gunnarfandrich/Sentinel/docs/Orin_Flashing.md

# Flashing the Jetson Orin Nano & Other/Older Variants

## Introduction
The Jetson Nano can prove difficult to flash due to the lack of documentation available online. This
document serves to fill in the gaps and aid in flashing all three developer kit models that exist at the
time of writing.

### Required Computer/Software
* A device with at least 64GB of storage running Ubuntu is required to
flash a Jetson Nano and its variants. Other linux distributions may work, though are untested.

  * Jetson Orin Nano: Ubuntu 20.04 or 22.04
  * (Older) Jetson Nano: Ubuntu 18.04

* An Nvidia account https://developer.nvidia.com/login

> **NOTE**  
> It would be advised to simply install Ubuntu to a removable storage device (such as an SD card
or USB drive) to avoid issues with installing to your main computer. A Live-CD cannot be used for
flashing a Jetson due to its lack in storage capacity.

### Required Hardware

A variant of the Jetson Orin Nano, or a variant of the older Jetson Nano (An incomplete list of variants are listed below)

<table border=1 frame=void rules=rows>
<tr>
<th>Variant</th>
<th>Device View</th>
</tr>
<tr>
<td>

Jetson Orin Nano Developer Kit
* Dev-22098
  * 8GB Model, without EMMC. Requires an NVME storage device to be installed.
  
> **NOTE**  
> Alternatively use a USB or SD Card, though these devices will be extremely slow and will face accelerated flash degredation in comparison to an NVME and are not recommended.

</td>
<td>
 


</td>
</tr>

<tr>
<td>

Jetson Nano Developer Kit 
* P3448-0003
  * 2GB model, without EMMC. Requires an SD card for the OS
to be installed to.
* P3448-0000
  * 4GB model, without EMMC. Requires an SD card for the OS
to be installed to.
* P3448-0002
  * 4GB model, with 16GB EMMC. Does NOT require an SD
card.

</td>
<td>

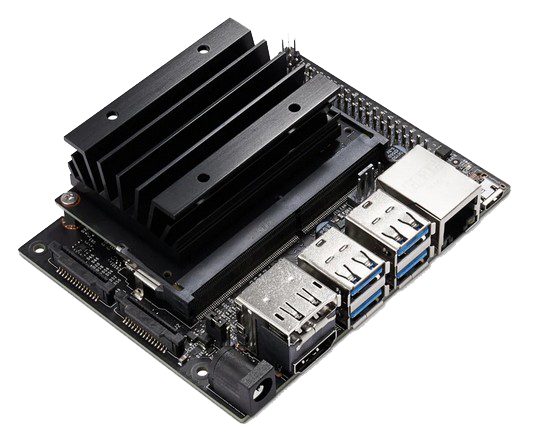
[picture p9: images/flashing/nano.png]


</td>
</tr>

<tr>
<td>

Jetson Xavier NX Developer Kit
* (Model number is unknown, but the internal PN is: 812674024318)
  * 16GB model, with 16GB EMMC.

</td>
<td>

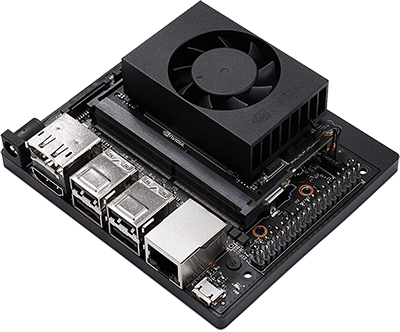
[picture p10: images/flashing/xavier.png]


</td>
</tr>

<tr>
<td>

Jetson AGX Orin Developer Kit
* (Model number is unknown, but the internal PN is: 945-13730-0000-000)
  * 64GB model, with 64GB EMMC.

</td>
<td>

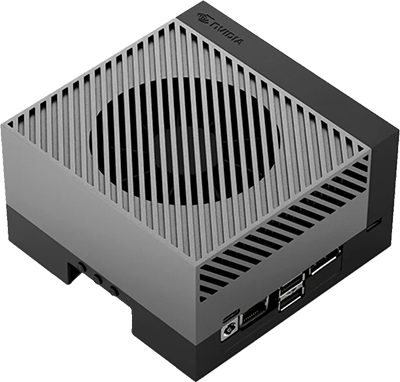
[picture p11: images/flashing/orin_agx.png]


</td>
</tr>
</table>

<table border=1 frame=void rules=rows>
<tr>
<th>Component</th>
<th>Component View</th>
</tr>
<tr>
<td>

* Standard Computer Jumper
  * These can be borrowed from an old computer motherboard you
may have laying around.
> **NOTE**  
>  A Female to Female breadboard wire will work in a
pinch.

</td>
<td>

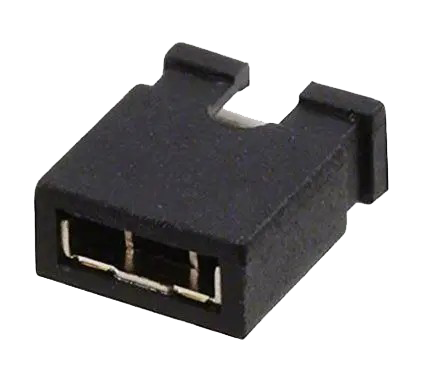
[picture p12: images/flashing/jumper.png]


</td>
</tr>
<tr>
<td>

(Micro-USB or USB-C) cable
  * Depending on the model daughter-board to be flashed, a Micro-
USB or USB-C cable is needed to connect the board to another
computer.

</td>
<td>

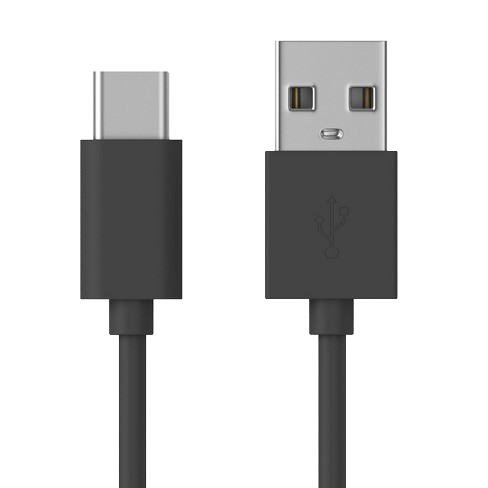
[picture p13: images/flashing/cable.png]


</td>
</tr>

<tr>
<td>
 
Power Supply (12V barrel jack or Micro-USB or USB-C)
  * Depending on the model daughterboard to be flashed, a 12V barrel
jack supply, Micro-USB, or USB-C power supply is necessary to
ensure a stable power supply while flashing.

</td>
<td>

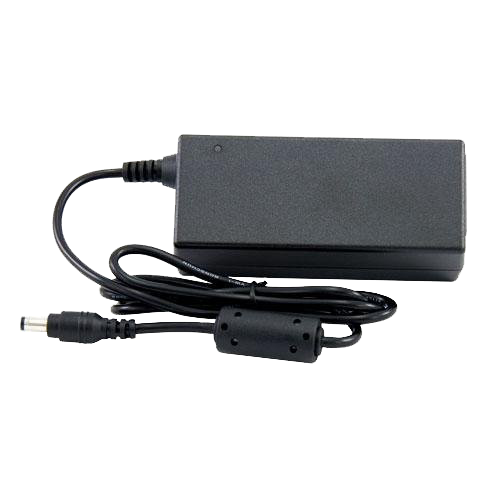
[picture p14: images/flashing/psu.png]


</td>
</tr>
</table>

## Flashing and Software Installation Process

### SDK Manager Installation

Navigate to the [Nvidia Website](https://developer.nvidia.com/sdk-manager) and download the appropriate package file for your desired operating system. For ubuntu, select the .deb file.

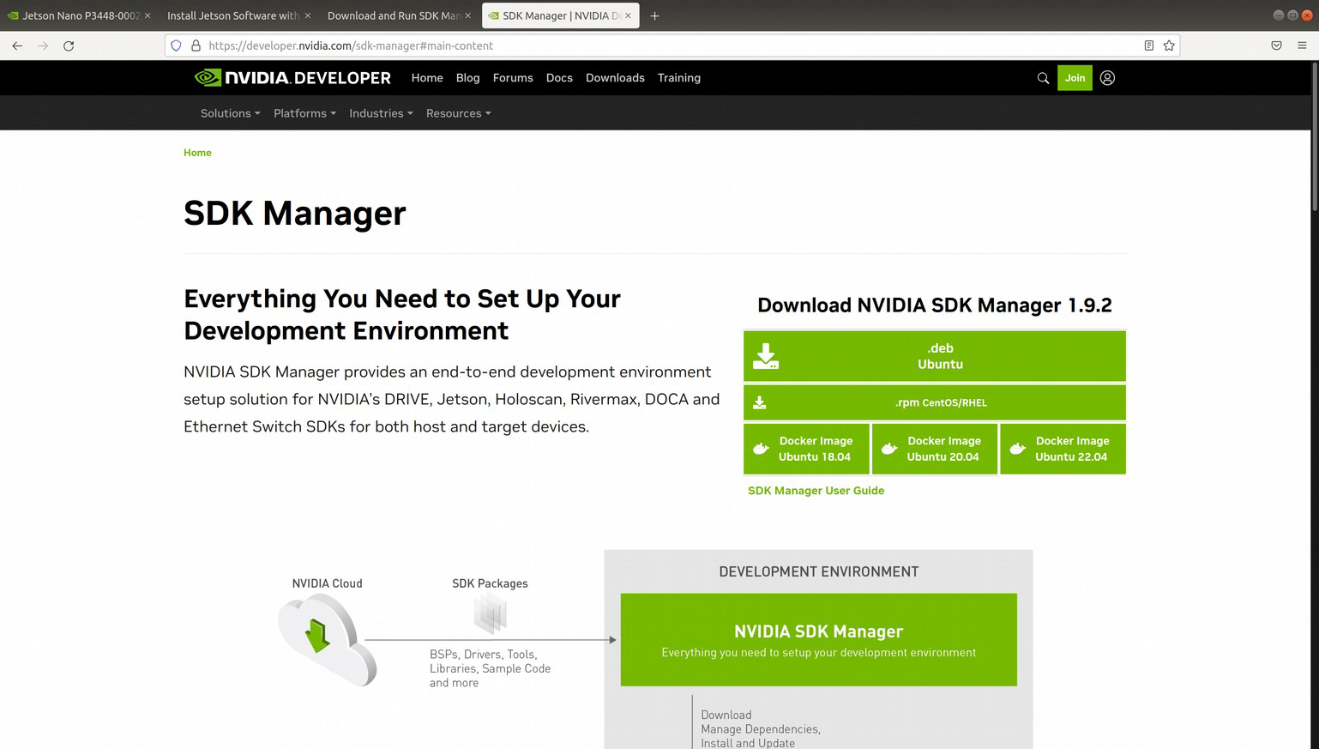
[picture p15: images/flashing/login.png]


Open a terminal and cd to the location of the downloaded file:
```sh
cd ~/Downloads
```

Attempt to install the sdkmanager:
```sh
sudo dpkg -i sdkmanager*.deb
```

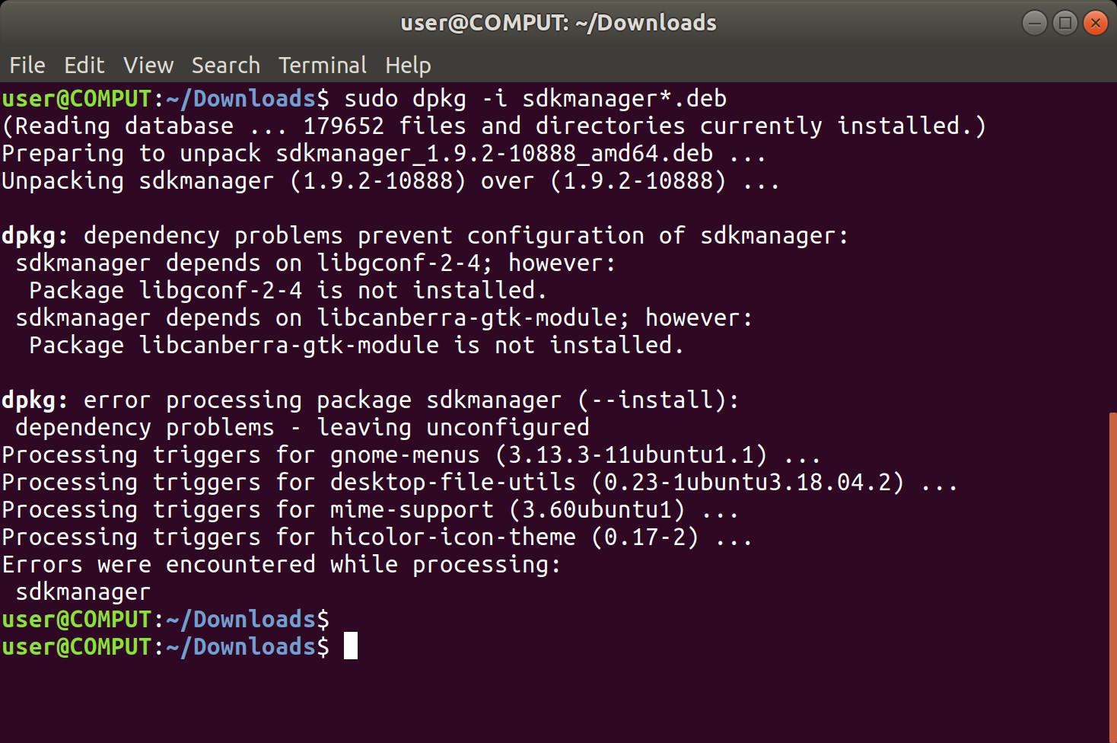
[picture p16: images/flashing/sdkmanager.png]


It is likely some dependencies will be missing. Common dependencies can be installed with the
following command:

```sh
sudo apt-get install libgconf-2-4 libcanberra-gtk-module gconf-service gconf2-common
libcanberra-gtk0 gconf-service-backend
```

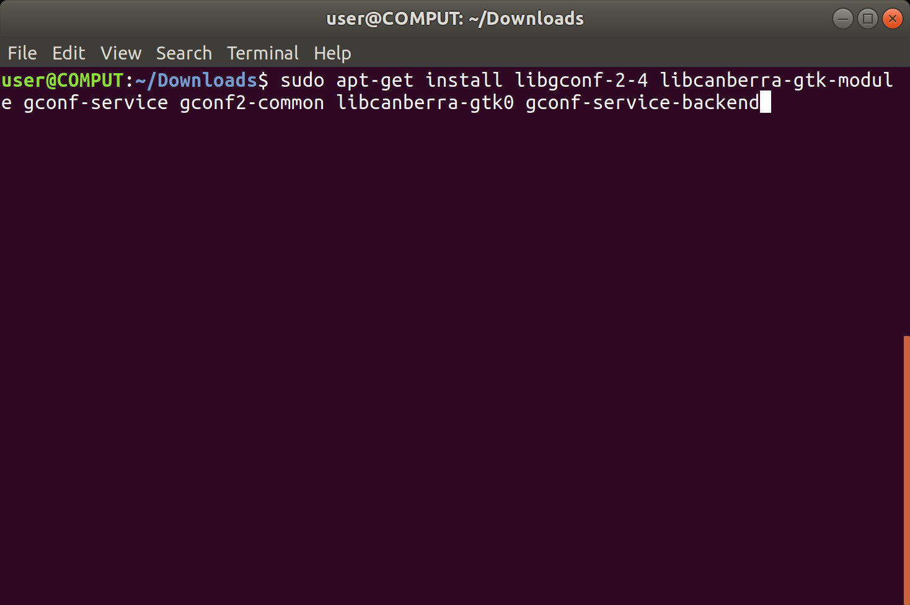
[picture p17: images/flashing/dependencies.png]


> **NOTE**
>  If any additional dependencies are required, simply review the terminal log to find the missing
packages and install them. An example is given below:
> ```sh
> sudo apt-get install libgconf-2-4
> ```

After installing necessary dependencies, attempt to install the sdkmanager again.
```sh
sudo dpkg -i sdkmanager*.deb
```

If no errors occur, proceed to the next step. Else, install any missing packages and repeat the install step
prior.

Once the sdkmanager is successfully installed without any errors, it may be launched with:
```sh
sdkmanager
```

On first launch, it will be necessary to sign into an Nvidia account to proceed. Once signed in, an
update window may open. Install updates as necessary and allow the sdkmanager to reopen.

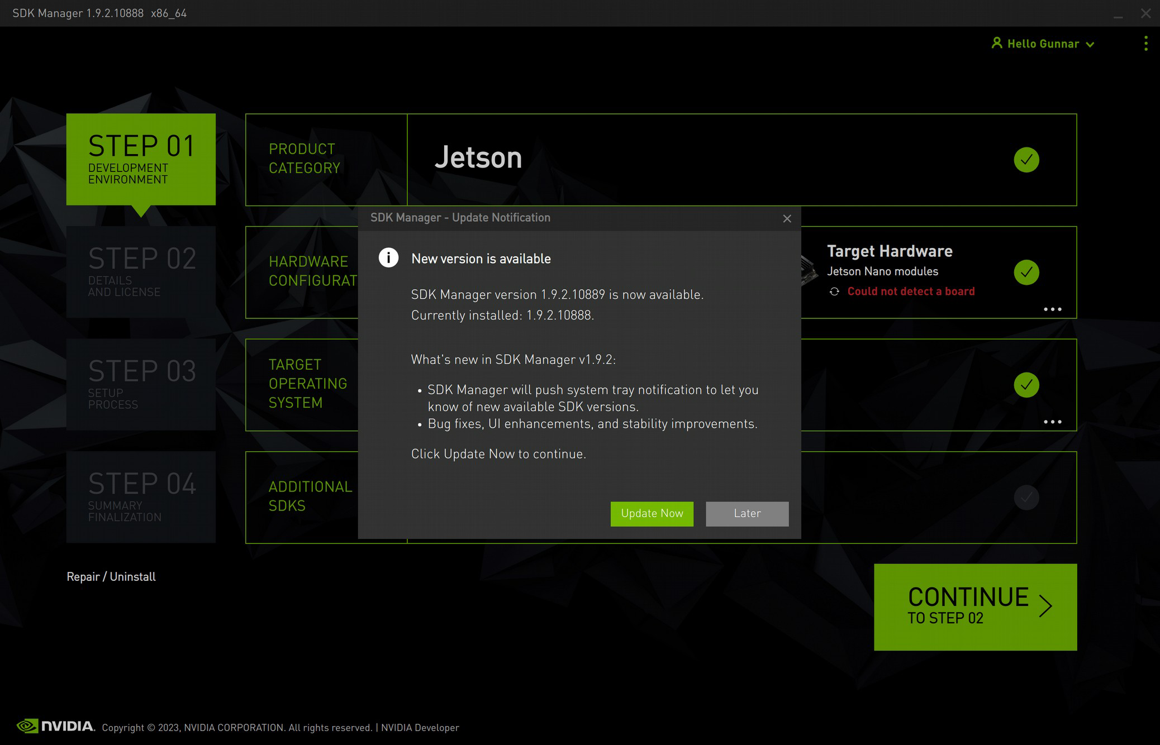
[picture p18: images/flashing/nvidia_update.png]


### Jetson Pre-Installation Preparation

Set the Jetson Nano Development kit to boot in recovery mode. This is done by utilizing a computer
jumper or female to female jumper wire to bridge the ‘FC_REC’ pin to any GND pin. The module has
been removed from its daughterboard in the following pictures to illustrate such process.

<p align="center">
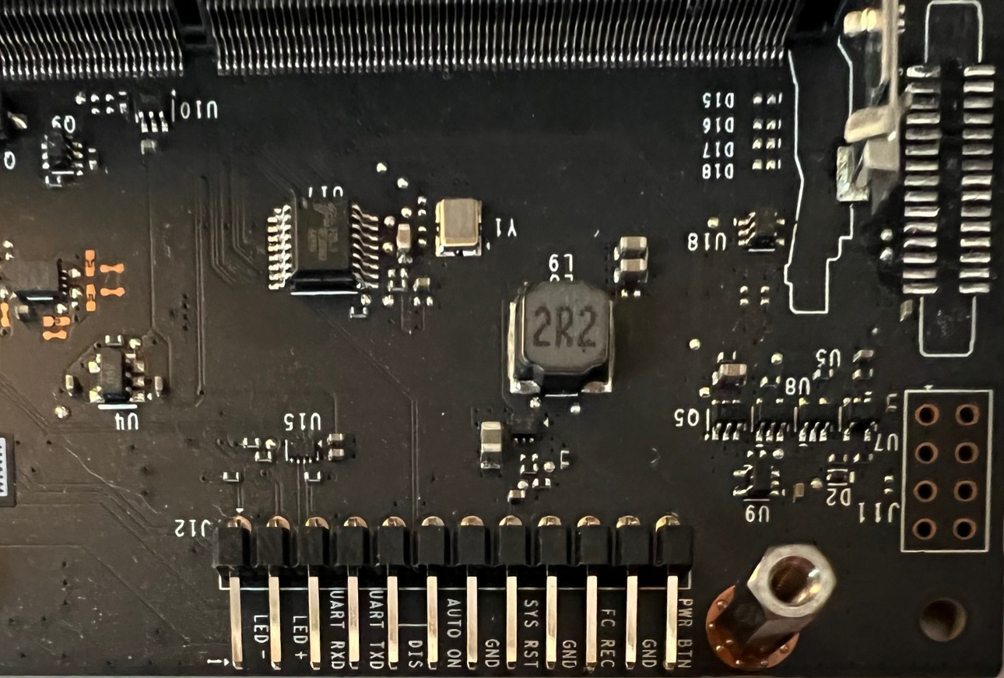
[picture p19: images/flashing/board_without_jumper.png]
 
</p>

<p align="center">
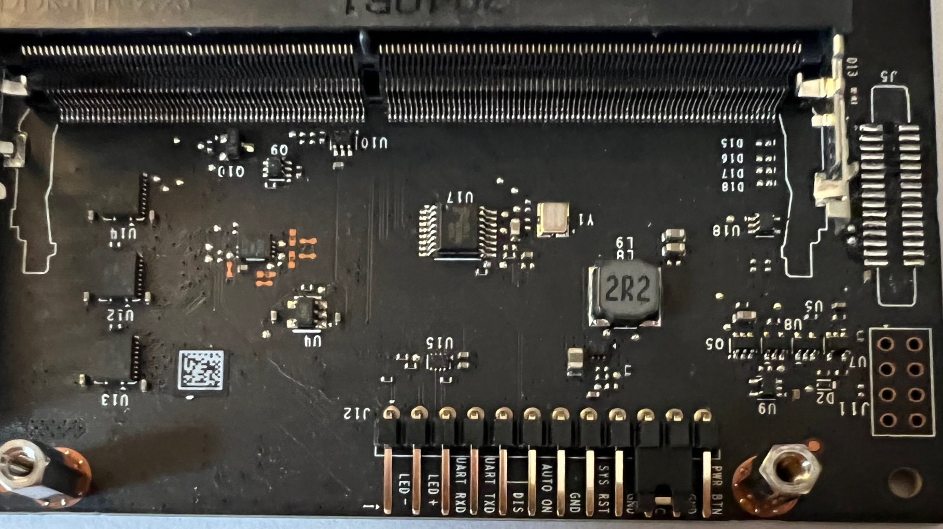
[picture p20: images/flashing/board_with_jumper.png]
 
</p>

<p align="center">
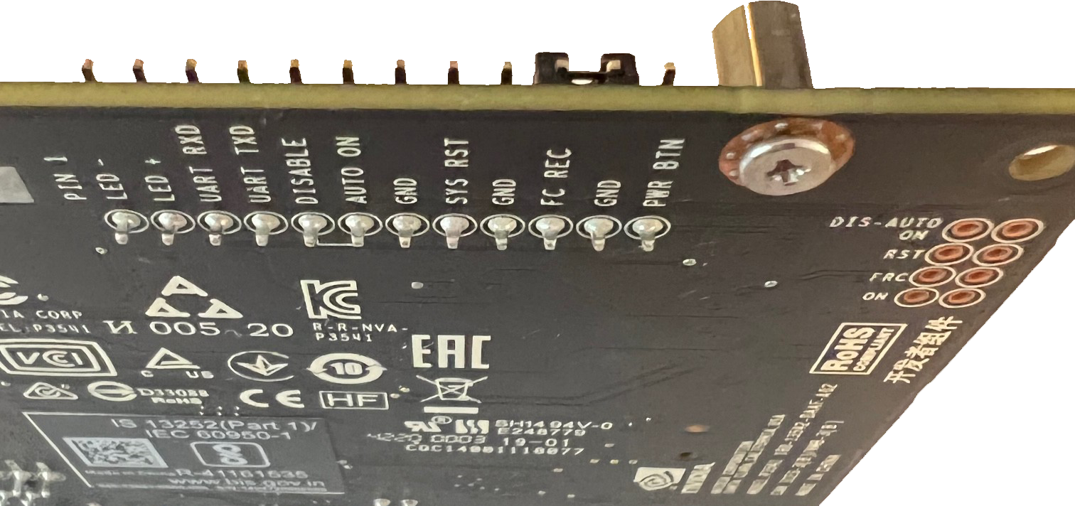
[picture p21: images/flashing/board_with_jumper2.png]
 
</p>

Once the recovery pin has been connected to ground, connect the power supply and Micro-USB or
USB-C cable to the computer running Ubuntu.

<p align="center">
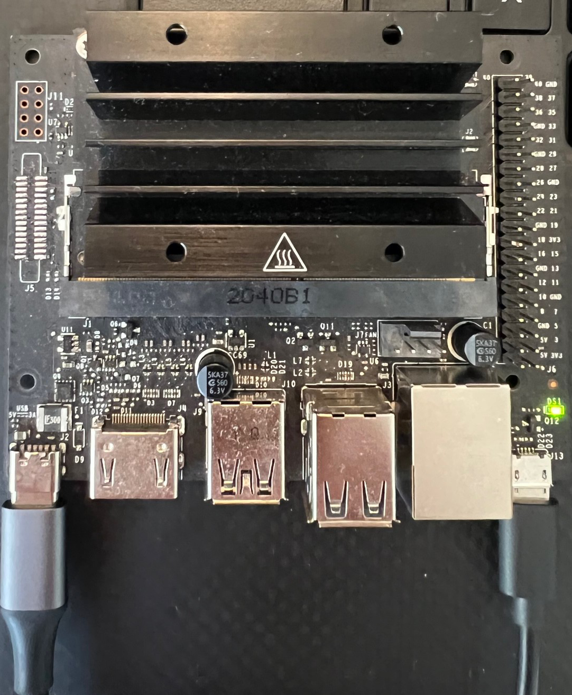
[picture p22: images/flashing/ready_to_flash.png]
 
</p>

### Jetson Flashing

#### Step 01
The sdkmanager should now auto-detect that a compatible device was connected.

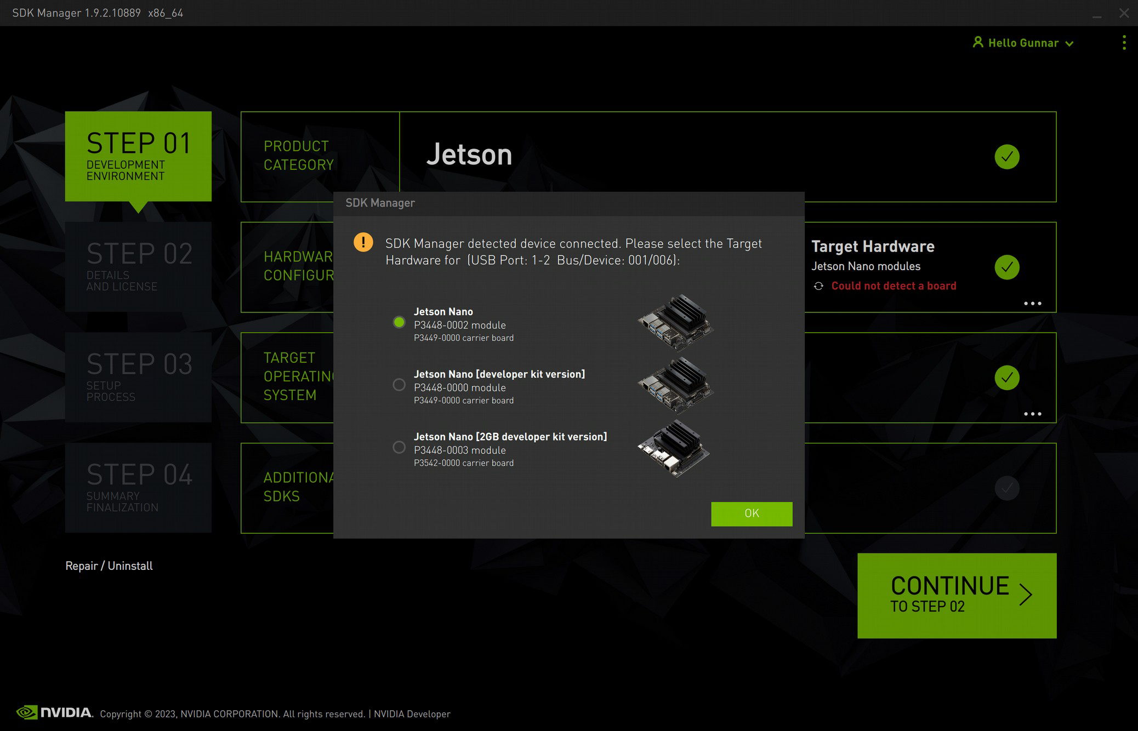
[picture p23: images/flashing/nvidia_detected.png]


* Select your appropriate device as listed on Pg. 1
* Pick an OS- The newest will typically be sufficient, though your mileage may vary.
* No additional SDKs are necessary to install.
* Proceed to Step 02.

#### Step 02

Now select the software to be installed. It is fine to select all components. Read and accept the terms
and conditions given by Nvidia to proceed.

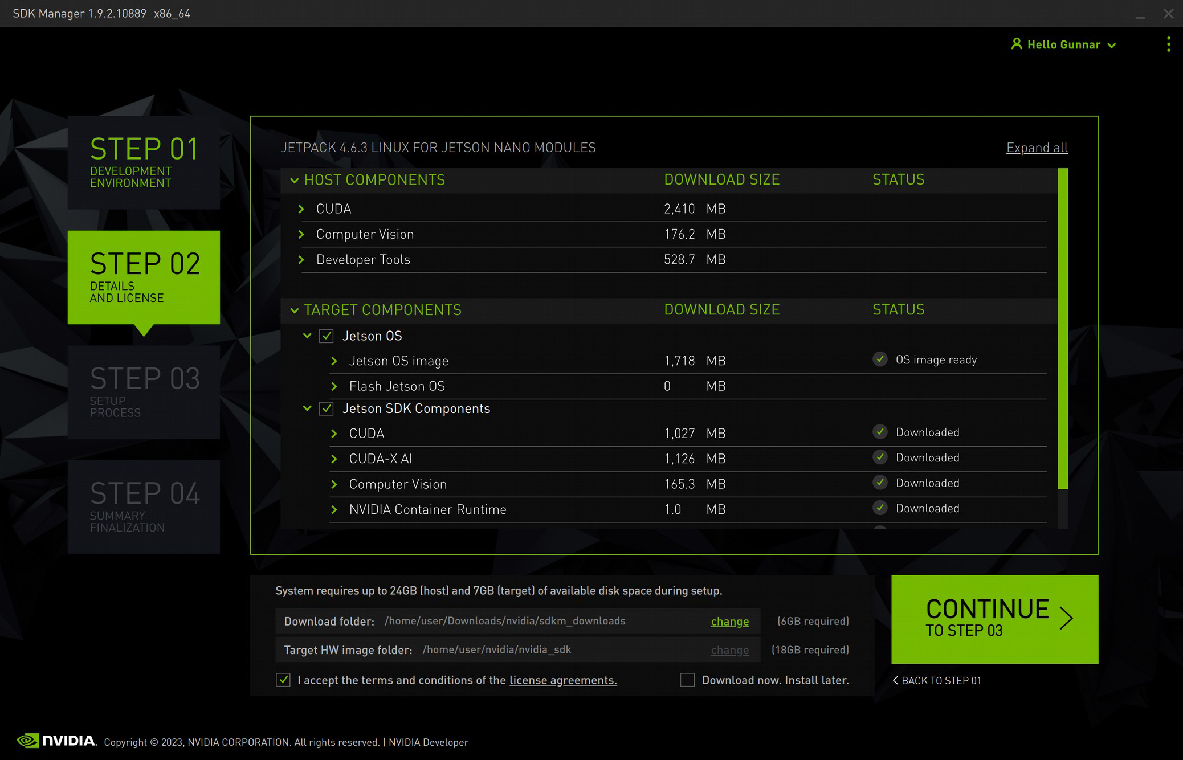
[picture p24: images/flashing/nvidia_package_selection.png]


Your device will now download the required software before flashing. Once complete, Step 03 will be
available to proceed to.

#### Step 03

* A window will open prompting the configuration of the Jetson. Your device should be the same as
selected prior. If not, select the correct device in the top drop-down menu.
* Select the **manual setup** pertaining to the model you selected prior.
* Select **Pre-Config** and choose a username and password.

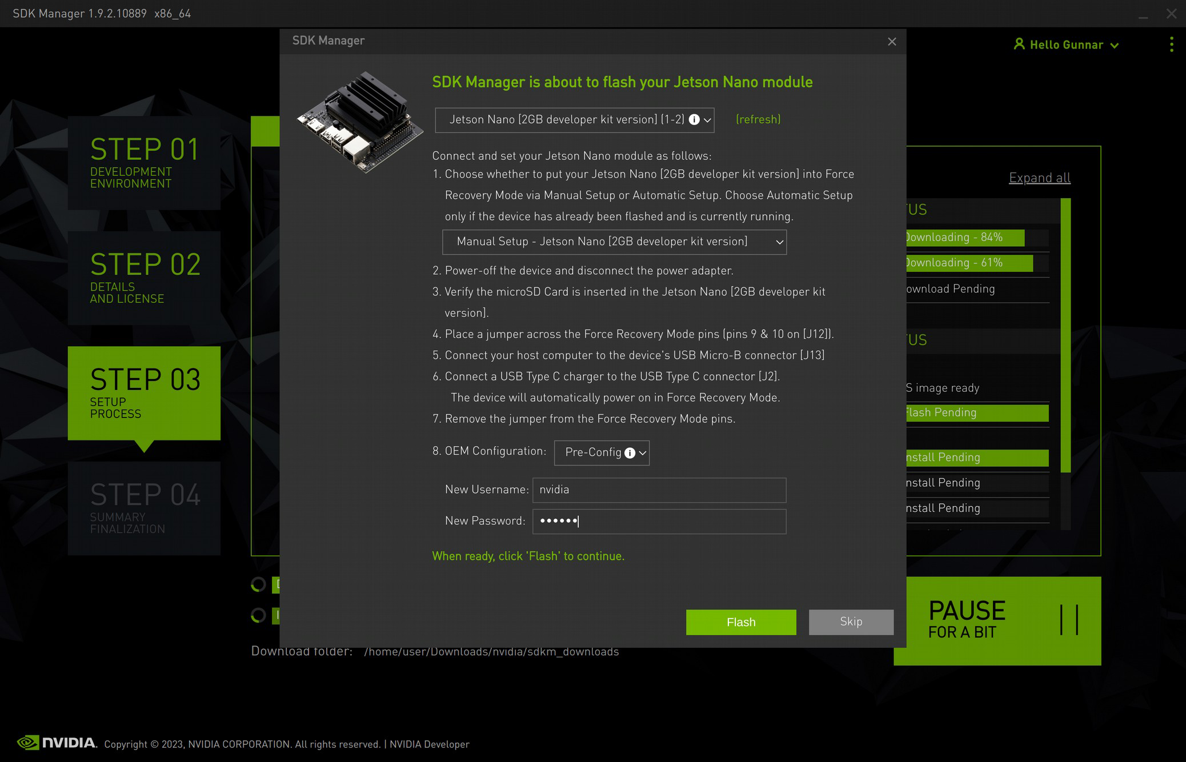
[picture p25: images/flashing/nvidia_device_selection.png]

  
> **NOTE**  
> In this example, the Username and Password are “nvidia” and a 2GB board without EMMC is
being flashed. MAKE SURE to select your correct board type and MANUAL method, otherwise you
will have to repeat the process. If flashing a Jetson without EMMC, ensure an SD card is inserted.

The device will now flash. The execution process can be monitored via the sdkmanager.

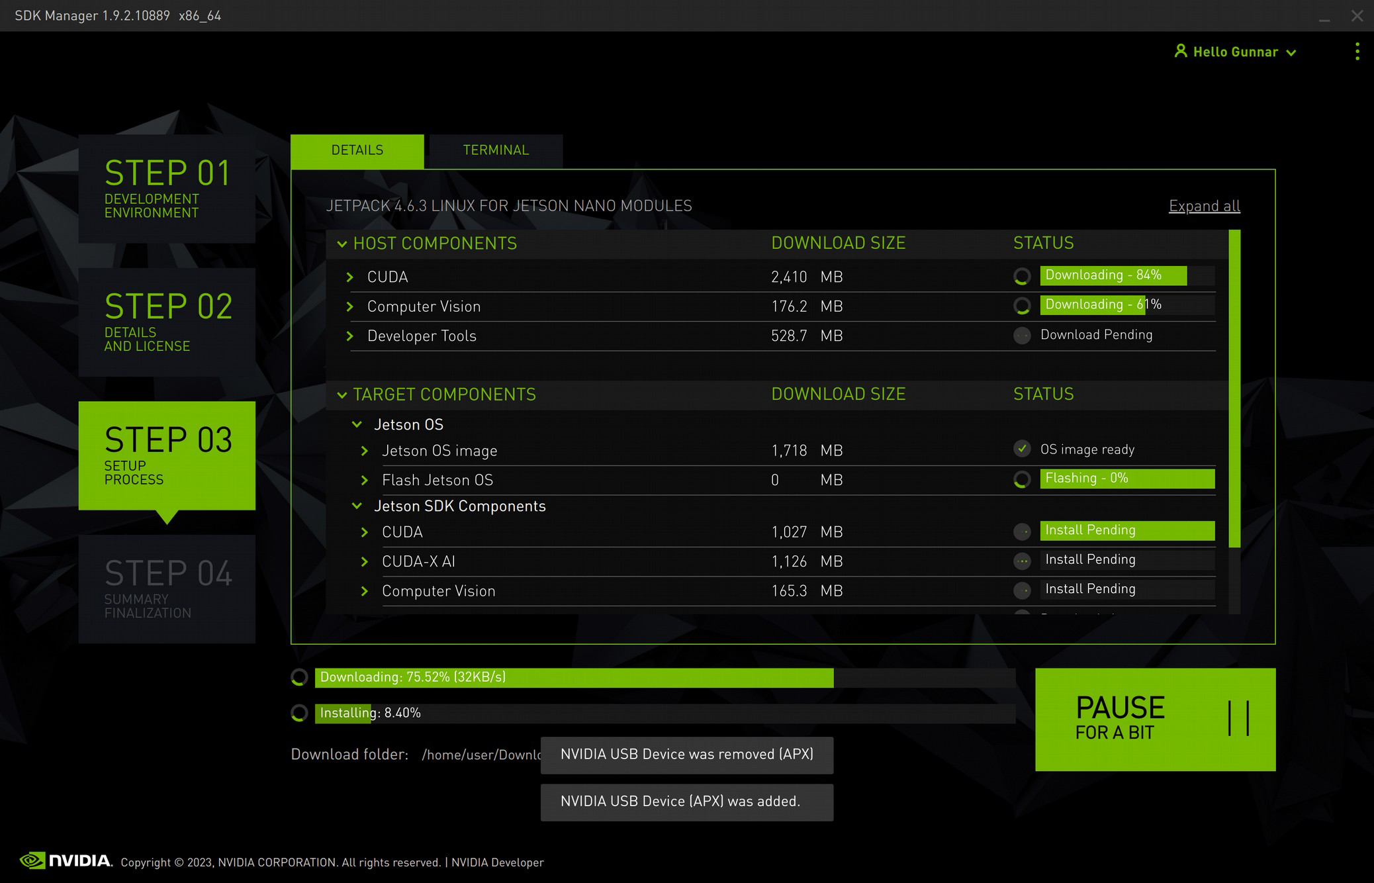
[picture p26: images/flashing/flash_progress.png]


> **NOTE**  
> Be sure to not unplug the power supply or the connection to the computer from the device
during flashing. It would be wise to also ensure the flashing computer is not set to sleep, to avoid
flashing problems. Sleep can be configured from Settings/Power in Ubuntu.

Let the device flash and follow any prompts from the sdkmanager. The sdkmanager will create a usbinternet
tunnel into the device and configure the username and password as entered.

### Post-Installation

As a tunnel to the device was created during installation, now is an optimal time to install any missing
packages. The IP of the device can be found with nmcli via the terminal. The default IP is:
```sh
192.168.55.1
```

SSH into the device as necessary nvidia@192.168.55.1 and install missing packages, such as WIFI, etc.

> **NOTE**
> If you changed the username, you would SSH into the device with username@192.168.55.1
