gunnarfandrich/Sentinel/images/hardwareComponents/block_diagram.jpg

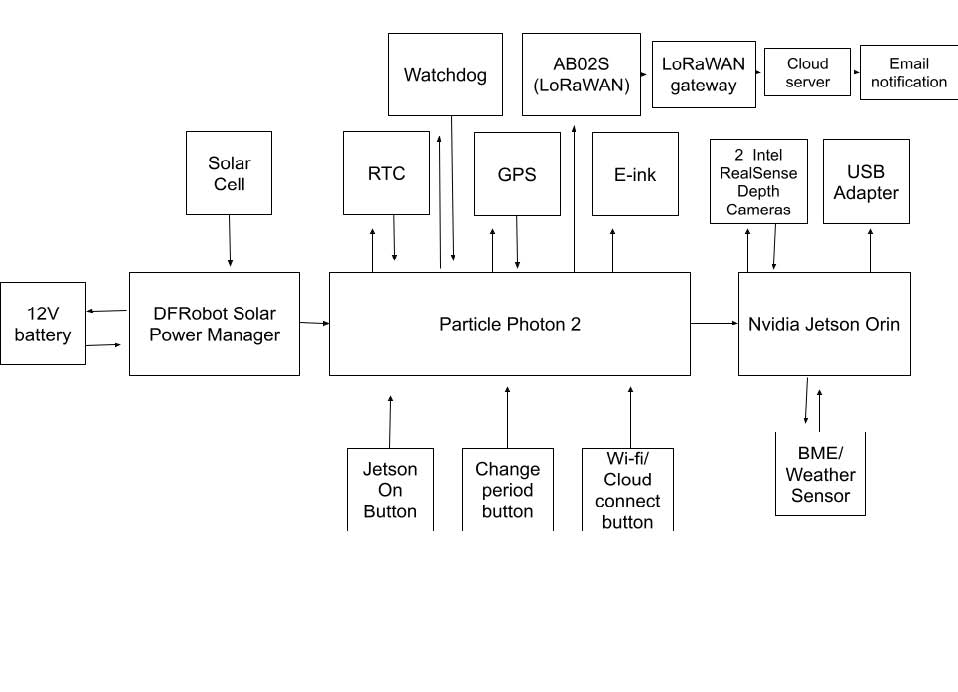
images/hardwareComponents/block_diagram.jpg
