gunnarfandrich/Sentinel/images/softwareComponents/software_flowchart.jpg

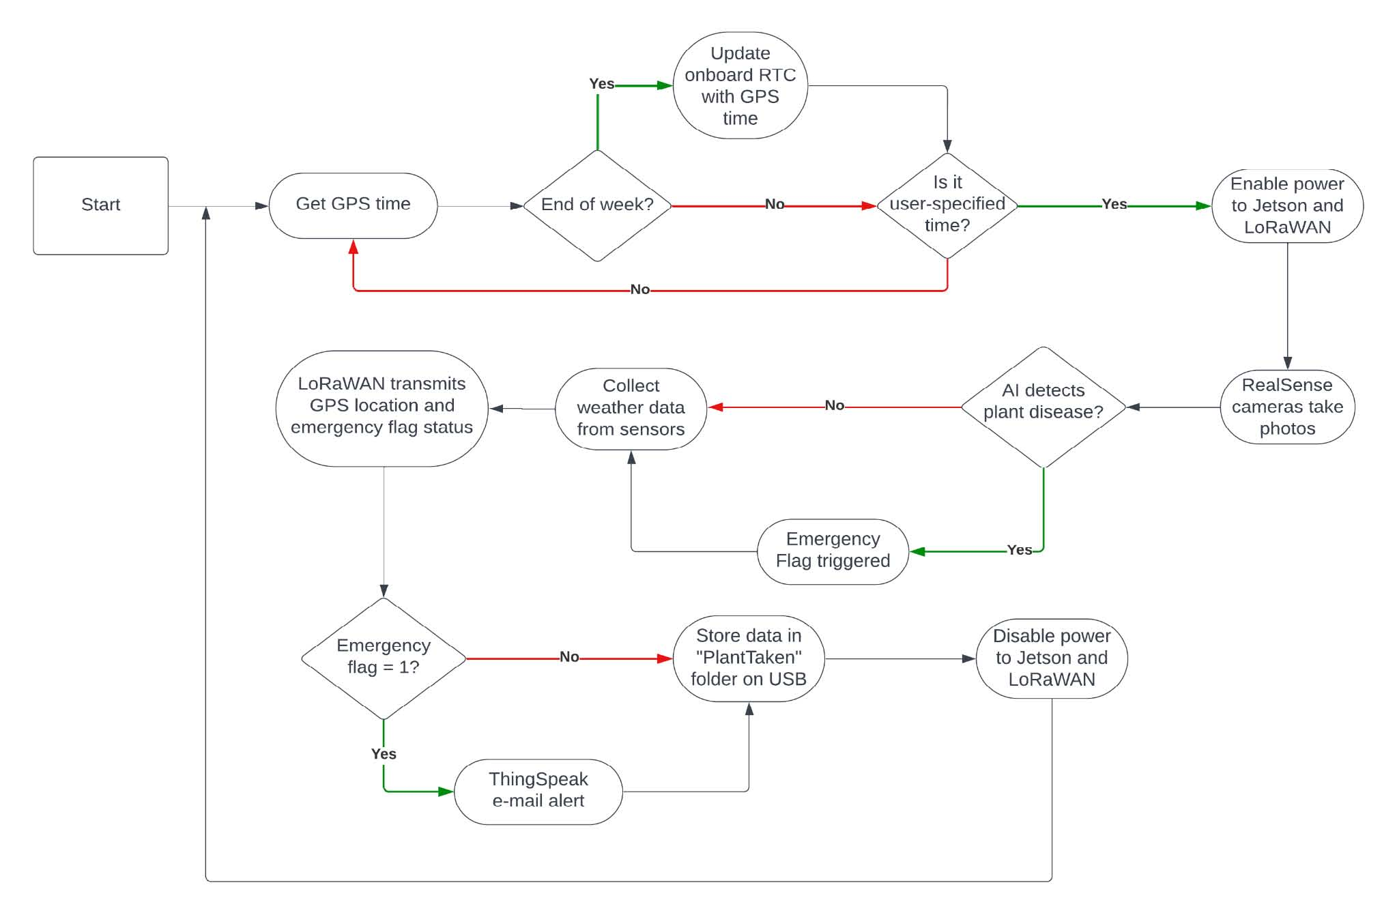
images/softwareComponents/software_flowchart.jpg
