gunnarfandrich/Sentinel/(commit log)

2023-01-09 added jetson files
2023-01-09 separated pico files
2024-07-20 Bump gunicorn in /jetsonNano/utils/google_app_engine
    Bumps [gunicorn](https://github.com/benoitc/gunicorn) from 19.9.0 to 22.0.0.
    - [Release notes](https://github.com/benoitc/gunicorn/releases)
    - [Commits](https://github.com/benoitc/gunicorn/compare/19.9.0...22.0.0)
    ---
    updated-dependencies:
    - dependency-name: gunicorn
    dependency-type: direct:production
    ...
2024-07-20 Bump flask from 1.0.2 to 2.2.5 in /jetsonNano/utils/google_app_engine
    Bumps [flask](https://github.com/pallets/flask) from 1.0.2 to 2.2.5.
    - [Release notes](https://github.com/pallets/flask/releases)
    - [Changelog](https://github.com/pallets/flask/blob/main/CHANGES.rst)
    - [Commits](https://github.com/pallets/flask/compare/1.0.2...2.2.5)
    - dependency-name: flask
    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
2024-07-20 Bump pip from 21.1 to 23.3 in /jetsonNano/utils/google_app_engine
    Bumps [pip](https://github.com/pypa/pip) from 21.1 to 23.3.
    - [Changelog](https://github.com/pypa/pip/blob/main/NEWS.rst)
    - [Commits](https://github.com/pypa/pip/compare/21.1...23.3)
    - dependency-name: pip
    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
2024-07-20 removed old pico code
2024-07-20 removed old jetson code
